swanmatch/silverbullet44/README.md

# SilverBullet44
## ビルドガイド

組み立て手順は[こちら](./docs/requiem.md)。  
(旧verは[こちら](./docs/silverbullet44.md)。)
