swanmatch/silverbullet44/pcb/footprints/1561131463590.jpg

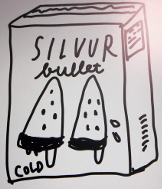
pcb/footprints/1561131463590.jpg
