swanmatch/silverbullet44/pcb/footprints/silverbullet.png

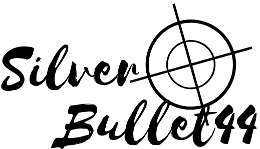
pcb/footprints/silverbullet.png
