swanmatch/silverbullet44/pcb/silverbullet44.png

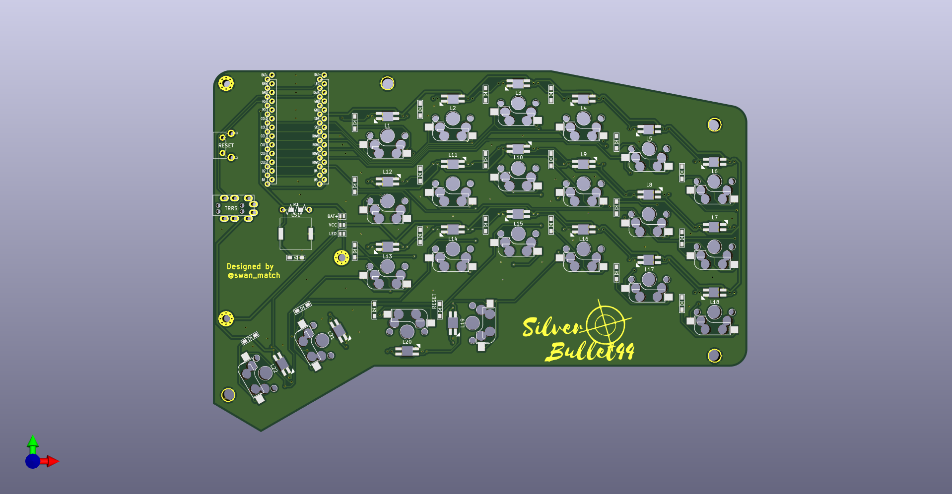
pcb/silverbullet44.png
