swanmatch/silverbullet44/shield/footprints/D8Ypb7MUcAEf9JY.jpg

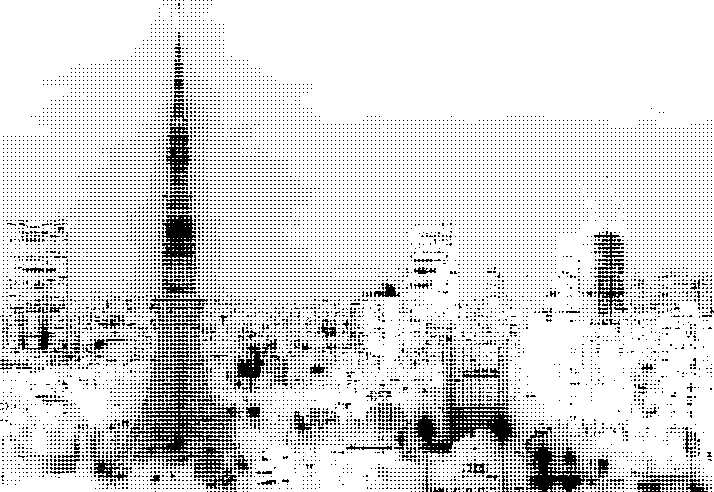
shield/footprints/D8Ypb7MUcAEf9JY.jpg
