swanmatch/silverbullet44/shield/footprints/IMG_20160221_104504.jpg

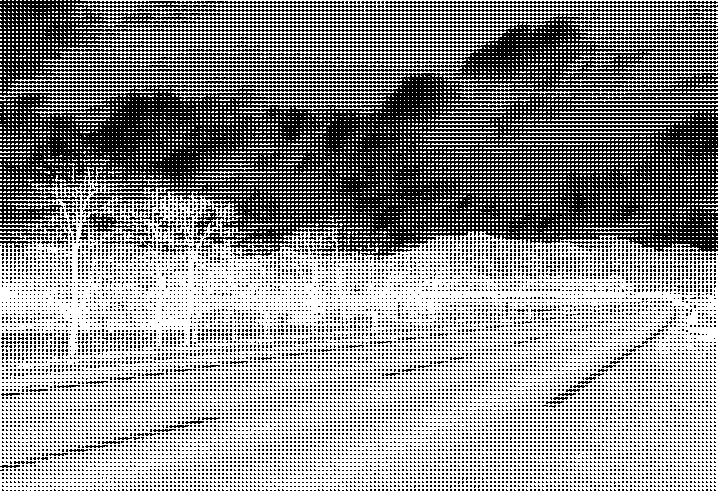
shield/footprints/IMG_20160221_104504.jpg
