swanmatch/silverbullet44/shield/footprints/nagano2.jpg

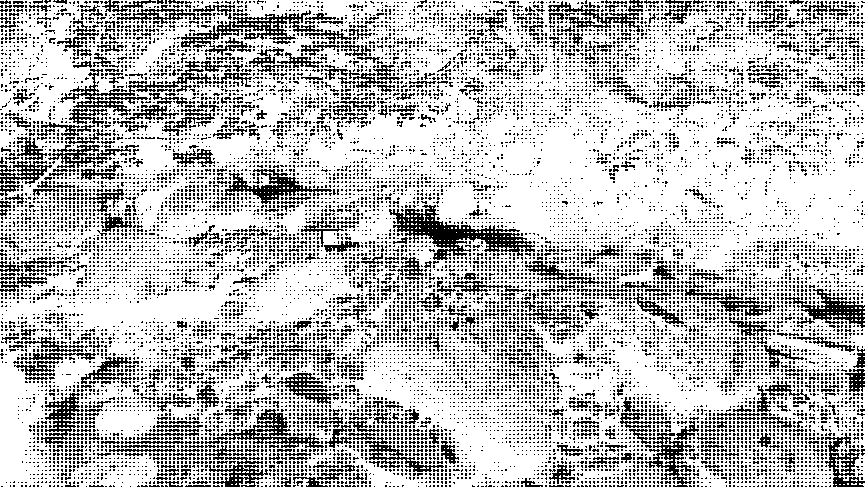
shield/footprints/nagano2.jpg
