swanmatch/silverbullet44/shield/footprints/nagano3.jpg

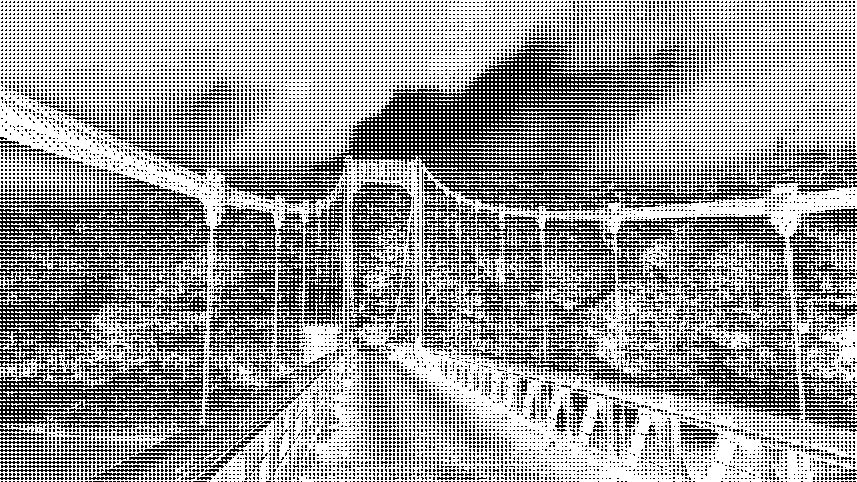
shield/footprints/nagano3.jpg
