swanmatch/silverbullet44/shield/footprints/nagano.jpg

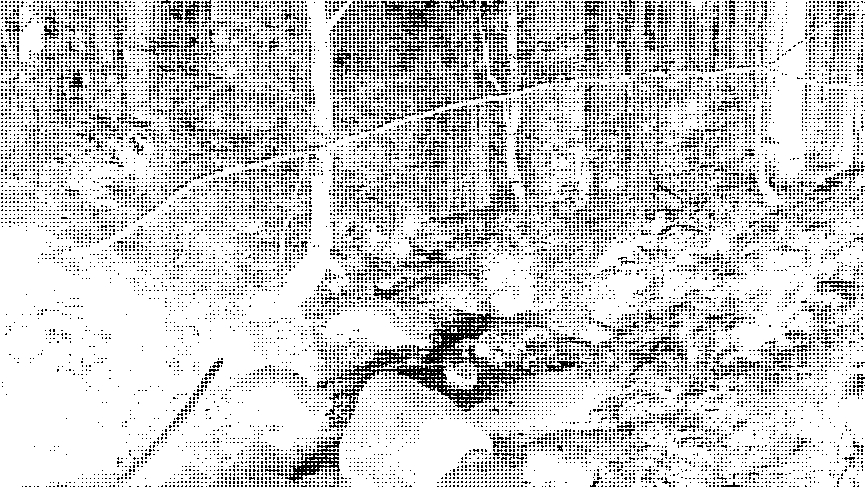
shield/footprints/nagano.jpg
