swanmatch/silverbullet44/acril_shield/ss_sheild_elecrow2_plane.dxf

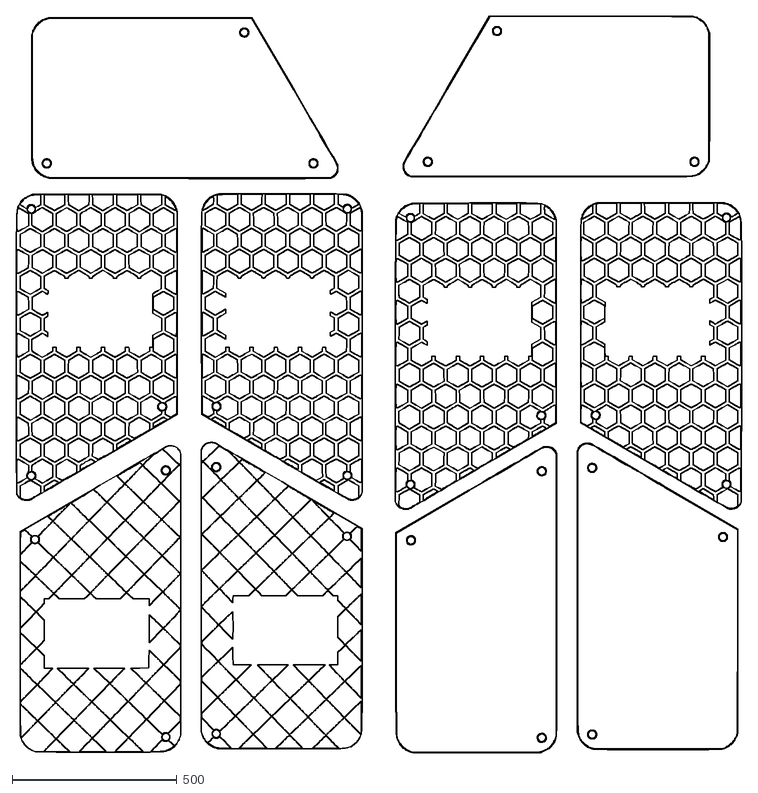
[picture p45: CAD file, 2021-02-13]
acril_shield/ss_sheild_elecrow2_plane.dxf
2202.9 x 2238.8
