swanmatch/silverbullet44/rest/restbottom.dxf

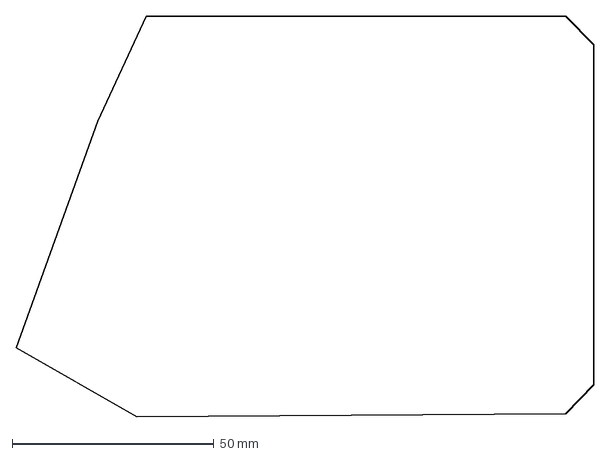
[picture p46: CAD file, 2021-02-13]
rest/restbottom.dxf
143.0 x 99.2 mm
