swanmatch/silverbullet44/rest3D/rest_plane_right.stl

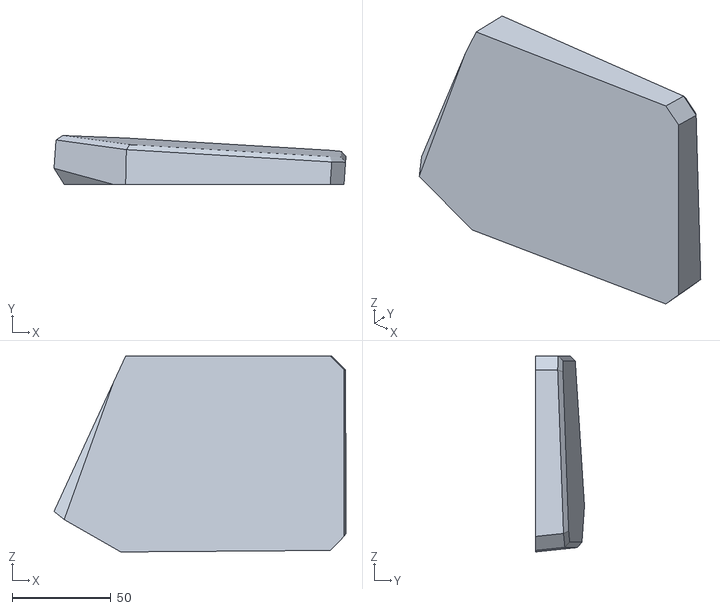
[picture p47: CAD file, 2021-09-20]
rest3D/rest_plane_right.stl
148.1 x 24.8 x 99.3
