swanmatch/silverbullet44/top.stl

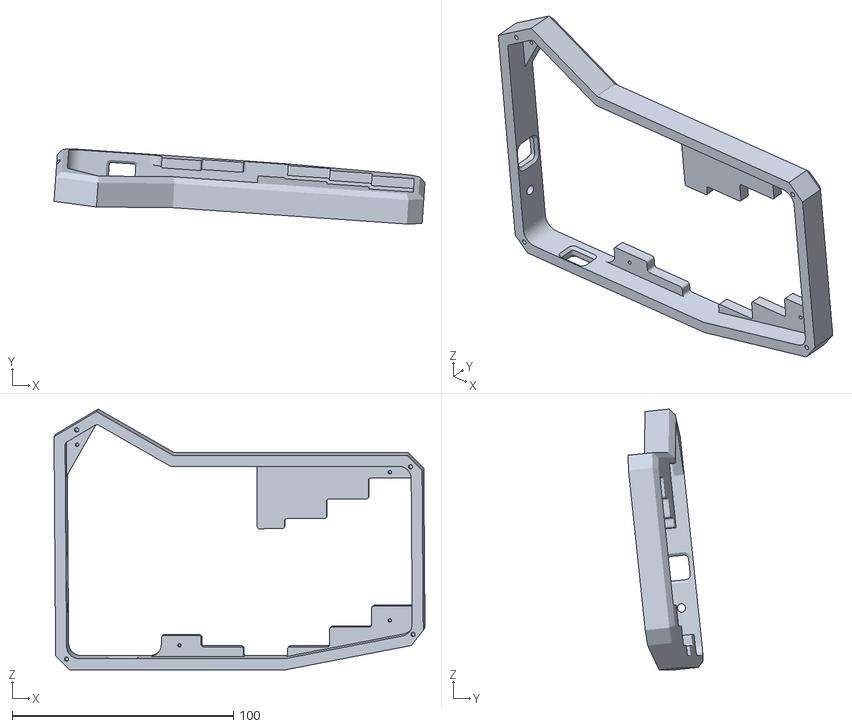
[picture p48: CAD file, 2020-12-13]
top.stl
167.6 x 33.9 x 117.8
