swanmatch/silverbullet44/acril_shield/ss_sheild_elecrow2.dxf

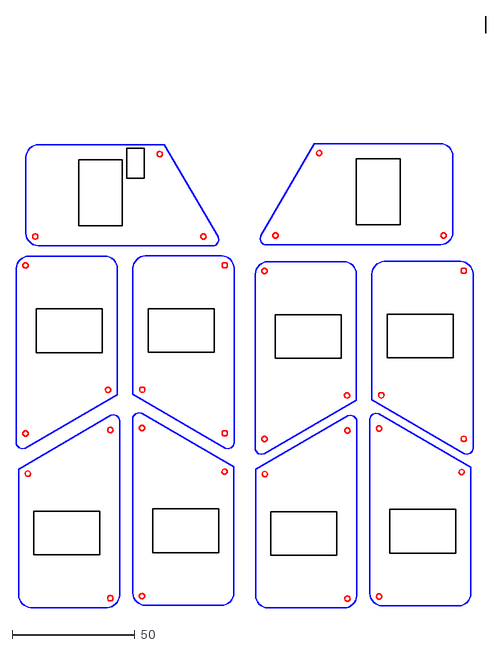
[picture p49: CAD file, 2021-02-13]
acril_shield/ss_sheild_elecrow2.dxf
191.6 x 241.5
