swanmatch/silverbullet44/rest/rest.step

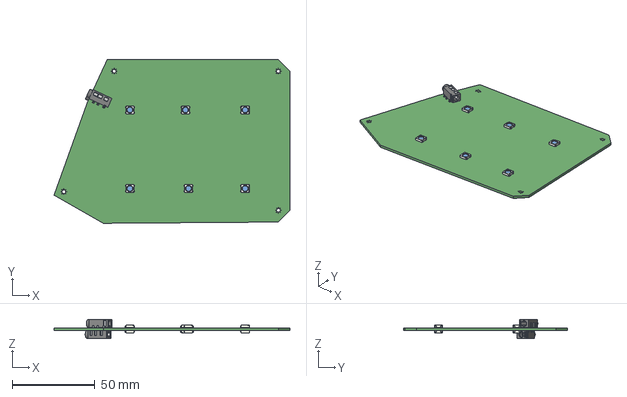
[picture p50: CAD file, 2021-02-13]
rest/rest.step
143.0 x 99.2 x 11.6 mm
