swanmatch/silverbullet44/rest3D/rest_light_right.stl

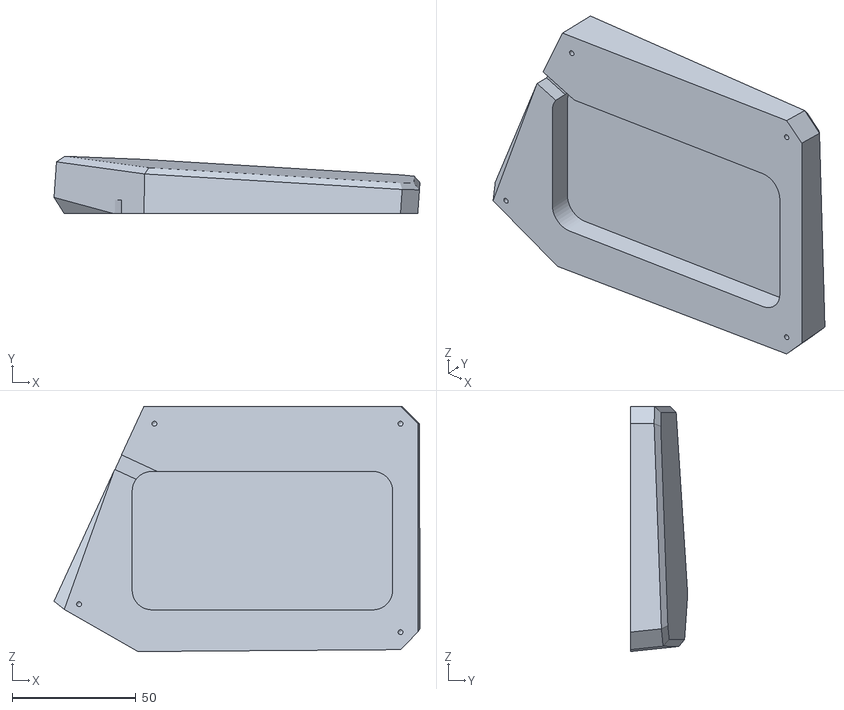
[picture p51: CAD file, 2021-09-20]
rest3D/rest_light_right.stl
148.1 x 23.2 x 99.2
