swanmatch/silverbullet44/(list of files, cad)

Other CAD files:
rest3D/rest_light_left.stl
rest3D/rest_plane_left.stl
acril_shield/ss_sheild_elecrow2.dwg
