swanmatch/silverbullet44/images/buildguide/requiem/process00.jpg

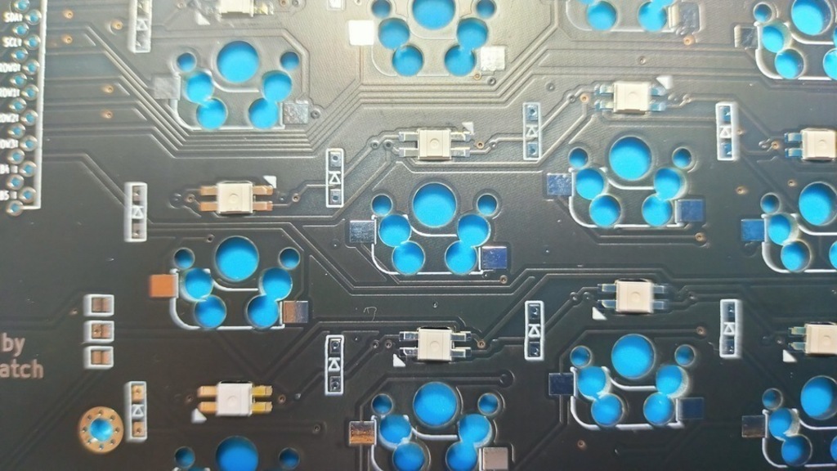
images/buildguide/requiem/process00.jpg
