swanmatch/silverbullet44/twoAcril/silverbullet44.pdf

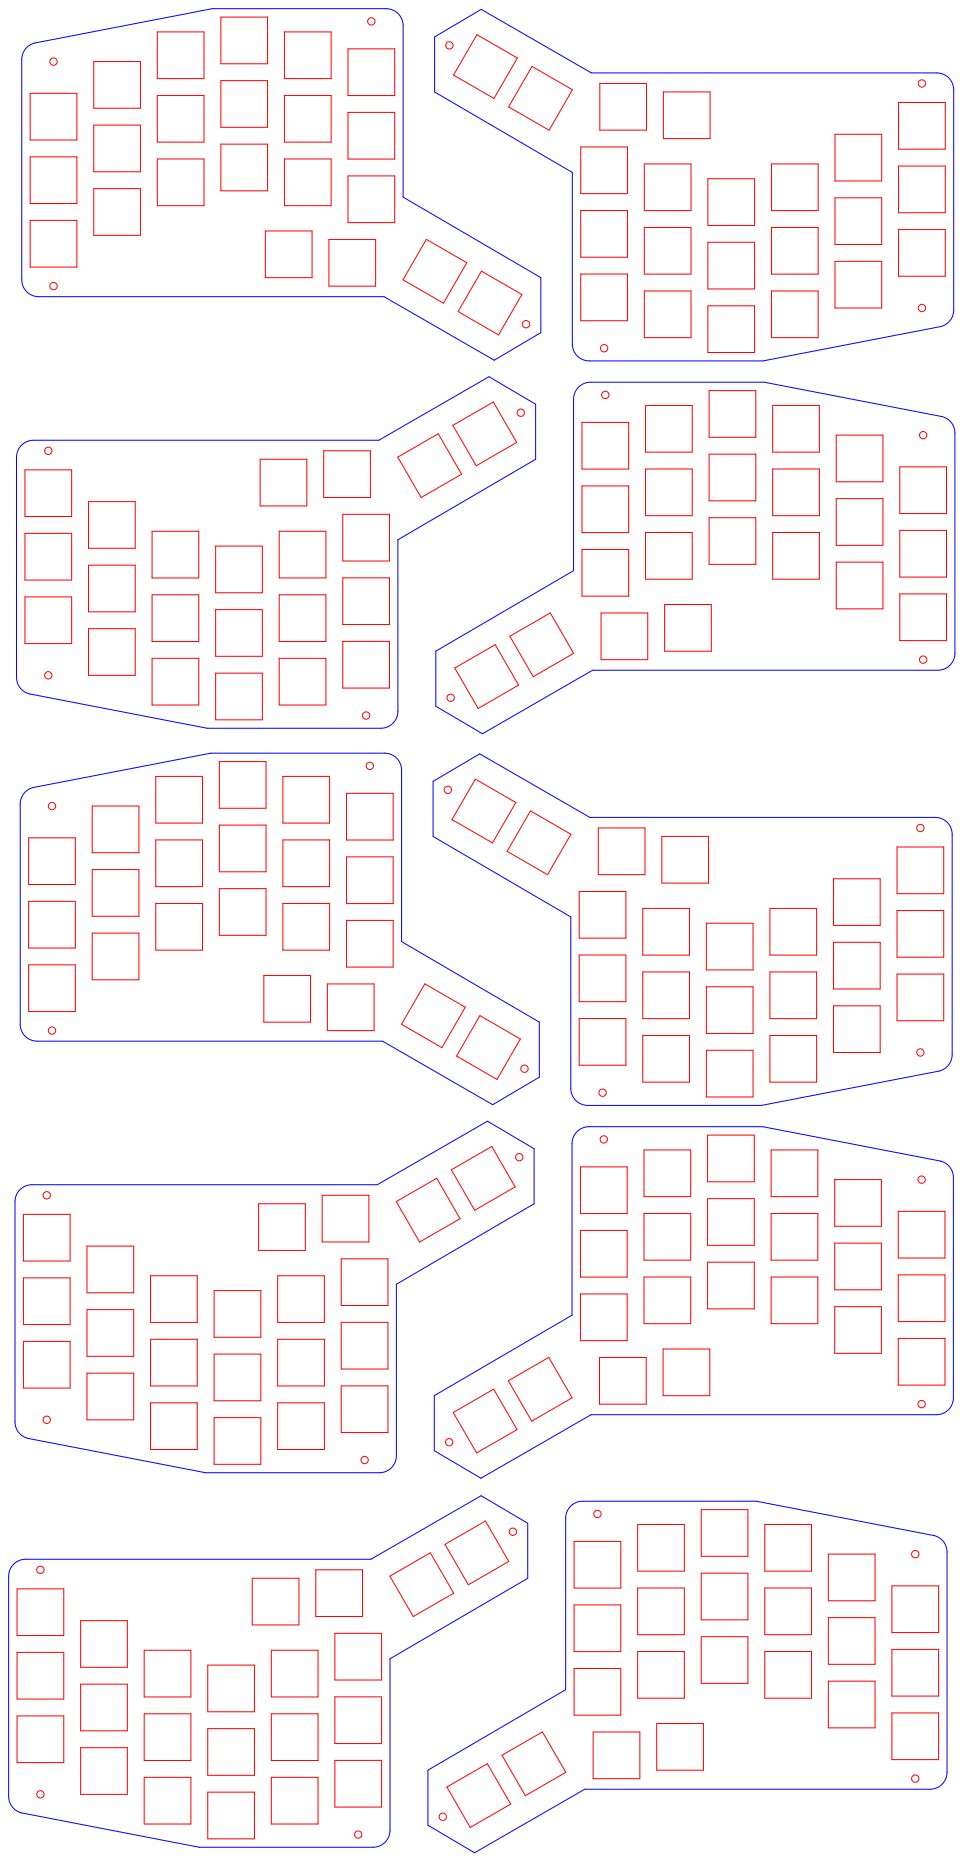
[picture p53: page 1]
