swanmatch/silverbullet44/acril_shield/ss_sheild_elecrow2.pdf

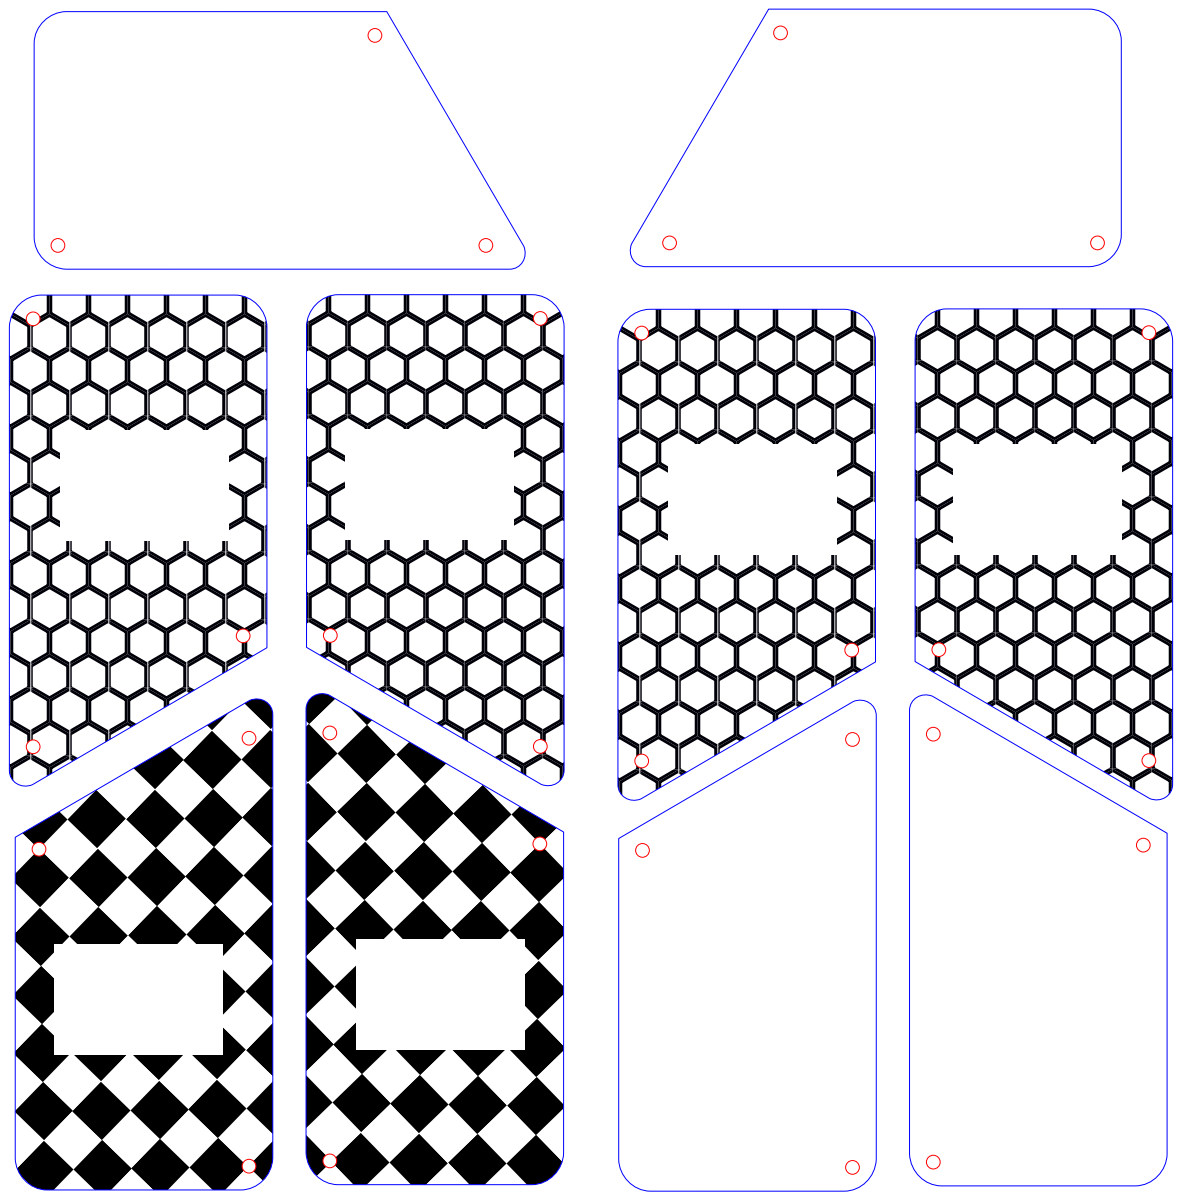
[picture p54: page 1]
