swanmatch/silverbullet44/acril_shield/ss_sheild_elecrow.pdf

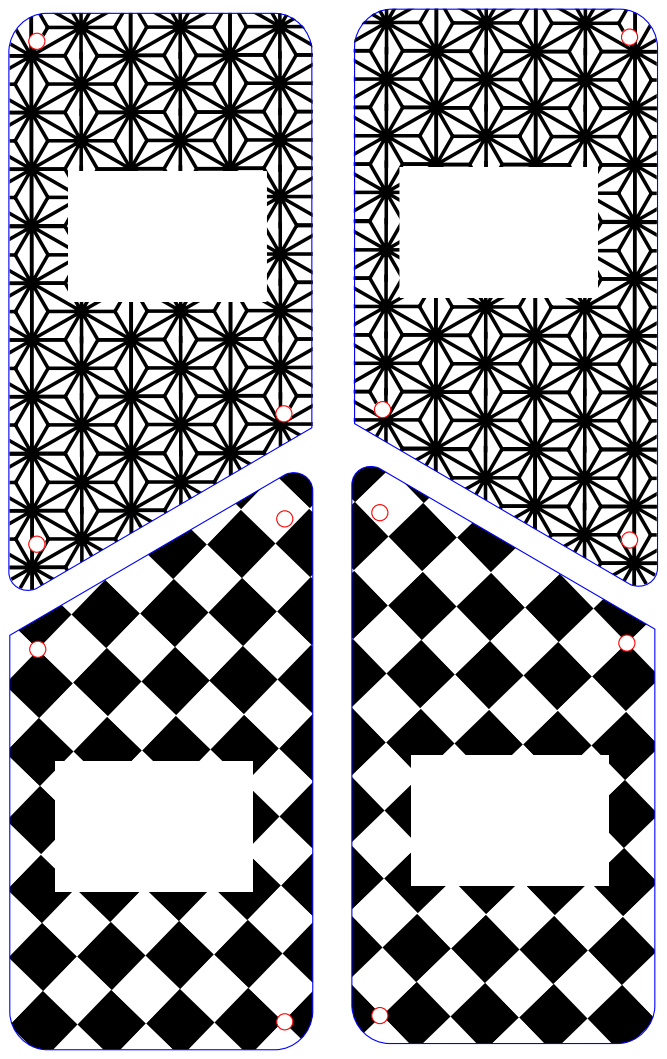
[picture p55: page 1]
