swanmatch/silverbullet44/(commit log)

2019-06-17 first order
    [bottom.kicad_pcb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]
2019-09-14 I'll stop choc switch... JOJO
    [case.kicad_pcb, case1.blend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]
2020-08-09 add a3 plate
2020-08-09 power lined
    [silverbullet44.kicad_pcb]
2020-08-10 deg LED
    [silverbullet44.kicad_pcb]
2020-08-10 route done
    [silverbullet44.kicad_pcb]
2020-08-14 add OLED
    [silverbullet44.kicad_pcb, silverbullet44.sch]
2020-12-13 Its time to requiem
    [bottom-B_Cu.gbl, bottom-B_Mask.gbs, bottom-B_Paste.gbp, bottom-B_SilkS.gbo, bottom-Edge_Cuts.gm1, bottom-F_Cu.gtl, bottom-F_Mask.gts, bottom-F_Paste.gtp]
2020-12-18 change shelds v-cut
    [shield.kicad_pcb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]
2021-01-12 fix TRRS and silk, and Add honeycomb acril shield
    [shield.drl, silverbullet44-B_Cu.gbl, silverbullet44-B_Mask.gbs, silverbullet44-B_SilkS.gbo, silverbullet44-Edge_Cuts.gm1, silverbullet44-F_Cu.gtl, silverbullet44-F_Mask.gts, silverbullet44-F_SilkS.gto]
2021-02-13 add dwg dxf acrilcut data.
    [silverbullet44-B_Cu.gbl, silverbullet44-B_Mask.gbs, silverbullet44-B_SilkS.gbo, silverbullet44-Edge_Cuts.gm1, silverbullet44-F_Cu.gtl, silverbullet44-F_Mask.gts, silverbullet44-F_SilkS.gto, silverbullet44.drl]
2021-02-13 add RestPCB
    [rest-B_Cu.gbr, rest-B_Mask.gbr, rest-B_SilkS.gbr, rest-Edge_Cuts.gbr, rest-F_Cu.gbr, rest-F_Mask.gbr, rest-F_SilkS.gbr, rest.drl]
2021-06-17 update readme.
    [rest-B_Cu.gbr, rest-B_Mask.gbr, rest-B_SilkS.gbr, rest-Edge_Cuts.gbr, rest-F_Cu.gbr, rest-F_Mask.gbr, rest-F_SilkS.gbr, rest.drl]
2021-09-20 add rest stls
    [rest_light_left.stl, rest_light_right.stl, rest_plane_left.stl, rest_plane_right.stl]
